Joshua2046c/replicator-project-6/product/README.md

# 四件式中式提灯

根据用户上传的提灯外形、补充角度和圆饼灯尺寸图制作：提手、底座、内胆、灯罩四个功能部件；提手拆为顶梁和两根竖杆，共六个独立打印实体。提手按最新参考改为双立杆支撑、两端上翘横梁的造型；灯罩改为上下圆弧过渡的直筒及纵向波纹，取消底部走线槽；灯罩与内胆磁吸位改为两处。底座与内胆下侧磁吸位也改为两处，底座外形与提手轮廓保持不变。仅参考新图的提手，不把提灯改成盒体。提手默认暖木色PETG，不代表采用实木工艺；其余保留青绿、米黄配色。按用户要求简化结构，去掉外伸耳座、锥形托台及叠层法兰。参考照片没有展示全部内部细节，浅托盘与镂空直筒的内部实现属于设计默认，并非照片实测结构。

## 明确要求
- 最新绿色标注区域整圈从顶到底统一壁厚，以原最薄处约1.2 mm为基准，包含纵向波纹、上肩圆弧和波纹下缘；内壁跟随外壁凹凸。
- 不再保留标注范围内原1.5 mm厚肩或上下厚壁渐变带；未标注磁铁安装环保留，孔位及装配尺寸不变。
- 灯罩纵向凹槽连续延伸经过收口肩部至口沿，不保留光滑肩带。
- 灯罩上口略微内收，内胆最高点不得高于灯罩口沿。
- 内胆容纳直径 60 mm、厚 8 mm 的成品圆饼灯组。
- 灯罩—内胆、内胆—底座以直径 7 mm、厚 2 mm 的磁铁配对连接。
- 顶梁与两根竖杆分件，竖杆顶端方桩插入顶梁底面配对盲孔。
- 提手与底座采用方桩固定；两侧方孔远离外边缘，插桩截面略缩小。
- 灯罩底部不再开走线凹口；保留内胆原有走线缺口，从灯罩下方外露灯杯引出导线。

## 本版默认尺寸和结构
- 装配目标外廓约 180 × 114 × 218 mm；灯罩主体高76 mm。横梁底面高192 mm，允许灯罩上提84 mm；越过内胆顶圈需要超过74 mm，保留约10 mm余量，避免横梁挡住拆卸。
- 底座是直径 114 mm、高 12 mm 的浅圆托盘，底厚 4 mm，盘内径 90 mm。方孔直接位于盘沿，不增加外伸耳座；提手下端向内折脚与盘沿连接。
- 灯罩采用半透明 PETG，40道纵向波纹，直筒中段不收腰；外径波谷106 mm、波峰109.6 mm，主体高76 mm。下端外径94 mm、圆弧过渡半径7.8 mm；上口波谷单边内收4 mm，波谷外径86 mm、波峰87.2 mm，以11.8 mm圆弧为上肩基准。凹槽从筒身连续到口沿，径向波深由1.8 mm渐变至0.6 mm。标注整圈内壁按外表面法线偏置约1.2 mm重建，取消原6 mm厚壁渐变带；上肩与直壁使用一致参数的波纹截面，避免放样扭曲。抽查直壁及上肩最小曲面距离1.1971 mm，波纹下缘至内侧底圆弧1.1988 mm，顶口轴向厚度1.2 mm。数值为CAD样条近似，不是打印公差。未标注底部磁吸环外径94 mm、高4 mm，局部加厚；孔不直接开在薄壁上。圆形顶孔82.4 mm和底孔69.2 mm不变，顶口平面径向宽度仍1.8–2.4 mm；该宽度不代表肩部法向壁厚。
- 内胆为一体直筒结构：下部直径 88 mm、高 28 mm 的圆柱灯杯，上部直径 68.4 mm 的镂空筒和顶圈，总高 102 mm。12 个竖向透光口直接开在筒壁上，没有独立立柱支架和锥形法兰。灯组槽直径 60.6 mm，底厚 6 mm；厚 8 mm 的灯从顶部直径 63 mm 开口取放。
- 灯罩从内胆上方直接套下，下口直径 69.2 mm 对内胆外径 68.4 mm，径向间隙 0.4 mm；在圆柱灯杯上端磁吸定位。顶部开口82.4 mm，内胆顶圈装配Z106、低于灯罩口沿Z108约2 mm，下部露出直筒灯杯。
- 灯罩—内胆改为两个对称定位点（0/180°），两侧各两枚、共四枚磁铁；内胆—底座也采用两个对称定位点（0/180°），两侧各两枚、共四枚，整灯合计8枚。两个点是每个接口的定位点数量，不是整灯磁铁总数。磁铁孔默认直径 7.2 mm、深 2.15 mm，给 Ø7×2 mm 磁铁留胶和打印误差空间。磁铁实际尺寸与孔的装配余量分开记录。
- 提手两立杆直径10 mm、中心距130 mm，底部保留内折脚以对接原有底座。横梁总宽180 mm、前后厚14 mm、中段高12 mm、两端相对中段上翘14 mm，端面斜切；顶梁与左右立杆分三件打印。顶部方桩6.4 × 6.4 mm、方孔6.8 × 6.8 mm，中心X±65 mm，单边间隙0.2 mm；桩顶Z200、孔顶Z200.2，端部留0.2 mm。名义桩长8 mm、孔深8.2 mm从横梁中段底面Z192计，杆肩贴合原下弧面，实际外露桩长约7.30–7.83 mm；顶梁前后孔壁各3.6 mm，孔顶剩余厚度至少3.8 mm。上下方桩均需胶接防拔。根部保留止挡肩，方桩缩为7.4 × 7.4 mm，插入8 mm；方孔为7.8 × 7.8 mm、深8.2 mm。孔与桩中心均为X±50.4 mm（中心距100.8 mm），相对原位置各内移0.6 mm，单边间隙0.2 mm；孔到内盘壁最小留肉1.5 mm，到外缘圆角起点的顶面最窄留肉约1.56 mm。方桩仍需胶接防拔。
- 仅保留内胆后部8 mm宽走线缺口，灯杯开口贯通到上沿。导线在底座盘沿Z12上方、灯罩底面Z32下方的外露灯杯处侧向引出，不夹在磁吸面之间。
- 除灯罩外采用不透明 PETG，颜色仅为设计默认。打印公差尚未用实物试装校准。

## 电气边界及证据
这是用户已有成品灯组的机械配套，依据上传尺寸图，不引入控制板、替换灯组或自定义 PCB。用户没有给出灯组品牌、电压、功率及接头尺寸；保留原装线和原配电源，不改线、不推断电源规格。灯组和磁铁不以猜测的供应商模型加入四件式 CAD。走线空间针对导线本体，内胆开放缺口使较大的接头无需穿孔；2 米线长来自图中标注，不要求收纳整条线。

## 验收及交付
交付含六个独立实体的 STEP 装配模型，检查六件之间无非预期干涉、两组磁铁孔共轴、方桩和方孔配合、圆饼灯腔及走线缺口尺寸。外观需要对照参考图检查。此版是可打印设计首版，打印层高、支撑、材料透光效果、胶接与磁力需样件验证。

## 独立水波纹替换灯罩
保留原提灯及纵向波纹灯罩，额外制作一个可互换的水波纹灯罩并放在旁边。参考上传金属壶的自然流动海浪纹，波带不能层层等宽或平行复制；每条波带沿圆周渐宽、渐窄，每道棱线独立起伏，相邻棱线自然靠拢、展开，同时保留清晰棱脊和立体明暗。标注的内凹过渡改为顺滑弧面；凸起棱脊的折角和邻近原斜面保持不变。默认半透明PETG。

默认沿用高76 mm、最大外径约109.6 mm、顶孔82.4 mm、底孔69.2 mm及两处Ø7.2×2.15 mm磁铁孔（半径39.2 mm、0/180°）。内壁随外形按约1.2 mm面法向偏置，棱角处以内侧斜面交线连接；底部4 mm磁吸环加厚。默认5道不平行的流动棱线，各层使用不同高度、弯曲相位、起伏幅度和局部宽窄分配。波谷控制点的名义深度3.2 mm，加入弧面后实际凹谷较控制点更柔和；13 mm仅作为总体轴向跨度控制，不是固定层距。默认凹谷过渡覆盖原谷点到两侧棱线各65%的范围，采用相切二次曲线，不是固定半径圆角；靠近凸棱的35%原斜面保留。主波4 mm、次波1.2 mm按各层系数和相位分别叠加；上下收口用圆弧轮廓的分段斜面自然收束。展示位置在原提灯右侧180 mm，底面同为Z32 mm；实际装配时与原灯罩择一使用，不能叠装。备用灯罩另需两枚Ø7×2 mm磁铁，连同原灯共10枚。
