Joshua2046c/replicator-project-6/design/lantern/README.md

# 中式四件提灯

四个功能部件、六个独立打印实体：顶梁、左竖杆、右竖杆组成提手，另外为浅圆托盘、镂空直筒内胆、圆弧直筒波纹薄壁灯罩。按补充角度简化，删除外伸耳座、锥台、多层法兰及三柱支架；只保留必要的磁吸环面。灯罩取消双鼓收腰，改为上下圆弧过渡的直筒，外围40道纵向波纹；取消灯罩底部走线槽。上口略微内收，40道凹槽连续经过收口肩部至口沿，内胆顶圈低于灯罩口沿，不向上突出。镂空直筒是本版默认内部实现，不声称由照片确认了隐藏结构。

用户指定灯组 Ø60×8 mm，磁铁 Ø7×2 mm。灯组品牌、电压及功率未知，保留原配线束和电源，不新增电路；空 connections 表示无新接线，不代表电气验证。

## 接口
- 最新绿色标注整圈从上肩到纵向波纹下缘统一约1.2 mm法向壁厚，以原最薄处为基准；内外40道凹凸对应。不再保留原厚肩或6 mm渐变厚壁带。依据 shade_uniform_wall_reference。
- 保留顶孔82.4 mm、底孔69.2 mm和未标注磁铁安装环（外径94 mm、高4 mm、两孔Ø7.2×2.15 mm）。外表面用一致参数重建波纹放样，保持外廓、波纹数量和收口尺寸。
- 灯腔 Ø60.6 mm，座面装配 Z10，8 mm 灯顶面 Z18，杯口 Z32；顶部取放孔 Ø63 mm。
- 底座—内胆 Z4，两处0/180°；内胆—灯罩 Z32，两处0/180°。两组磁铁孔分布半径均39.2 mm，孔 Ø7.2×2.15 mm。灯罩侧两枚、内胆上侧两枚、内胆下侧两枚、底座两枚，共8枚 Ø7×2 mm磁铁。
- 提手方桩与方孔中心 X±50.4 mm，中心距100.8 mm，各比原位置向内移0.6 mm；方桩7.4 mm配7.8 mm方孔，单边间隙0.2 mm，插深8 mm，孔深8.2 mm。孔至内盘壁留肉1.5 mm；孔外角至底座外圆角起点的顶面留肉约1.56 mm（原约0.8 mm）。方孔直接开在盘沿，胶接固定。
- 内胆直筒外径68.4 mm，灯罩下口69.2 mm，径向装配间隙0.4 mm；灯罩可从上方套入或提起，不会被顶圈扣住。
- 只保留内胆负Y方向8 mm宽走线缺口，从灯座面开到杯口，与一处筒壁透光口对齐。灯罩底部完整无走线开槽；导线从外露灯杯侧面引出。
- 最新提手照片登记为 handle_reference，明确采用双立杆与翘头横梁；当前保留该提手，灯罩及内胆上侧磁铁孔按最新标注更新。根据 beam_joint_reference 将提手分为顶梁、左竖杆、右竖杆三个实体，以顶部方桩连接，底部插桩、立杆间距和翘头横梁轮廓不变。方孔与插桩修改标注为 square_joint_reference。底座与内胆两点磁吸标注为 base_magnets_reference，凹槽延伸收口标注为 rim_fluting_reference，收口与内胆高度标注为 rim_revision_reference，灯罩修改标注为 shade_revision_reference，补充提灯照片为 lantern_reference_side；外廓、透光口数量、隐藏结构和暖木色PETG属于设计默认。

- 顶部方桩6.4 mm、配对盲孔6.8 mm，中心X±65 mm，单边间隙0.2 mm；桩顶Z200、孔顶Z200.2，端部余量0.2 mm。名义桩长8 mm和孔深8.2 mm从Z192计；杆肩贴合顶梁原下弧面，实际外露桩长约7.30–7.83 mm。孔前后壁各3.6 mm，孔顶厚度至少3.8 mm。直方桩采用胶接防拔，不是卡扣。

## Making and assembly
默认0.4 mm喷嘴、0.16–0.20 mm层高；提手分顶梁与两根竖杆分别用PETG打印，默认暖木色而非实木。顶梁宽侧面平放，竖杆沿长度方向平放，使上下方桩轴线位于打印平面内，避免沿承力方向叠层。圆杆下侧、折脚和上下方桩需切片检查局部支撑与床面接触，勿让方桩配合面被支撑损坏；顶梁盲孔的横向桥接也需检查。底座底面向下。内胆灯杯底面向下，筒壁竖向肋低速打印；透光窗口顶部约9 mm桥接需检查切片。灯罩竖直、下环放平台，薄壁用半透明PETG；上口内收后的肩部检查局部支撑与悬垂，不能用花瓶单壁模式，因为底环含磁铁盲孔。薄壁筒身需在切片预览中检查连续壁线，不能把1.2 mm简单等同于固定三圈实际线宽。模型未实际打印。

先干试方桩和磁铁孔，需要时通过参数调整补偿。确认每对磁铁相吸后标记，少量胶粘并防止固化前移位。先粘底座两枚与内胆下侧两枚，再粘内胆上侧两枚及灯罩两枚磁铁；上下接口均为两对，分别核对配对极性。先干试顶梁与两根竖杆，保持折脚向内、两组方桩中心对齐；将顶部两方桩胶接到顶梁盲孔，再将底部两方桩胶接到盘沿，所有承力胶接完全固化后才可提起；直方桩的打印间隙不是防拔锁扣。

灯从内胆顶部放到底面，导线从负Y方向侧向放入缺口，再放上内胆和灯罩。底座盘沿会遮住低处一小段缺口，导线须向上绕至盘沿上方，在Z12至Z32的外露灯杯区域侧向引出，不夹在磁吸面之间。磁铁若各下沉0.15 mm，两侧总气隙0.3 mm，实际吸力须样件验证。维修时先提灯罩再取内胆，禁止以灯罩代替提手悬提。灯组发热、透光、磁力承重与胶接寿命均未实测。

## 尺寸与验证边界
目标外廓180×114×218 mm。底座外径114 mm、高12 mm、底厚4 mm、内径90 mm；内胆灯杯外径88 mm，在托盘内径向间隙1 mm。提手立杆直径10 mm、中心距130 mm；横梁宽180 mm、深14 mm、中段高12 mm、端部上翘14 mm。灯罩主体高76 mm，直筒波谷直径106 mm、波峰109.6 mm，下端外径94 mm、外部圆弧半径7.8 mm；上口波谷单边内收4 mm，波谷外径86 mm、波峰87.2 mm；以11.8 mm圆弧为上肩放样基准，纵向凹槽连续覆盖肩部并到达口沿，径向波深由筒身1.8 mm平滑渐变至口沿0.6 mm，口沿径向厚度1.8–2.4 mm。圆形顶孔仍为82.4 mm。40道纵向波纹，标注范围内直壁与上肩统一约1.2 mm法向壁厚。代表性曲面测量：直壁和上肩各1.1971 mm，下缘至底内圆弧1.1988 mm，顶口轴向1.2 mm；样条近似已按1.2±0.01 mm检查。未标注磁铁安装环局部加厚，不把环上径向安装面宽度当作透光壁厚。内胆总高102 mm，顶圈装配Z106 mm，比灯罩口沿Z108 mm低2 mm。横梁中段底面装配Z192 mm；灯罩顶面Z108 mm，可上提84 mm，脱离内胆需上提74 mm，保留约10 mm拆装余量。

本次几何和外观检查以产品验证记录所指向的确切模型为准；打印公差、材料透光和实际承重仍需实物验证。
