Joshua2046c/replicator-project-6/product/gallery/codex-image-2026-10-1-19-55-11.jpg

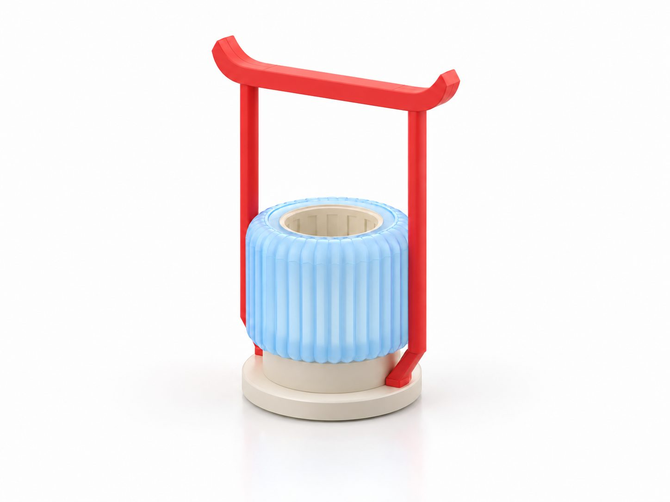
product/gallery/codex-image-2026-10-1-19-55-11.jpg
