Joshua2046c/replicator-project-6/product/bom.csv

id | name | quantity | source | notes
handle | 双盲孔翘头顶梁 PETG 暖木色 | 1 | default | 非实木 顶部方孔6.8mm 中心距130mm
handle_left_rod | 左竖杆 PETG 暖木色 | 1 | default | 上桩6.4mm 下桩7.4mm 上下均胶接
handle_right_rod | 右竖杆 PETG 暖木色 | 1 | default | 上桩6.4mm 下桩7.4mm 上下均胶接
base | 带双方孔浅圆托盘 PETG 青色 | 1 | default | 打印件 方孔7.8mm 中心距100.8mm
liner | 低于灯罩口沿的圆饼灯镂空直筒内胆 PETG 米黄色 | 1 | default | 打印件
shade | 整圈内外对应波纹等厚灯罩 约1.2mm 半透明PETG 绿色 | 1 | default | 标注上肩及筒壁同厚 未标注磁吸环保留 两处磁铁孔
magnet_7x2 | 轴向充磁圆片磁铁 Ø7×2 mm | 10 | user_dimensions | 原灯8枚 水波纹备用灯罩2枚
light_60x8 | 用户图示 Ø60×8 mm 圆饼灯组 含原装线及匹配电源 | 1 | user | 保留原装电气系统
adhesive | 适用于 PETG 与镀镍磁铁的双组分环氧胶 | 1 | default | 装配耗材
water_shade | 自然流动海浪纹替换灯罩 凹谷弧面及锐棱 约1.2mm 半透明PETG | 1 | default | 凹谷相切弧面 凸棱折角不变 宽窄自然变化 两处磁铁孔
