Joshua2046c/replicator-project-6/manufacturing/lantern/releases/export-cfa25840fb57574f5817fed4d6e9c91b/model.step

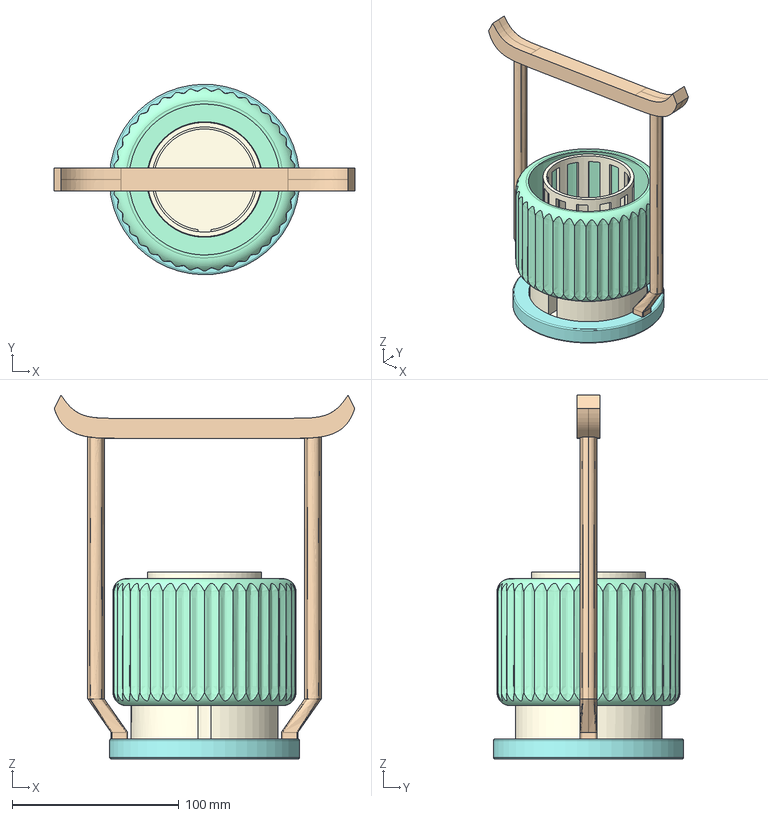
[picture p2: CAD file, 2026-09-25]
manufacturing/lantern/releases/export-cfa25840fb57574f5817fed4d6e9c91b/model.step
180.0 x 113.9 x 218.0 mm
base
ﾃδεつｧﾃδづつｿﾃδεつ･ﾃδづつ､ﾃδづつｴﾃδεつｦﾃδづつｨﾃδづつｪﾃδεつ ｦﾃδづつ｢ﾃδεつｦﾃδεつｦ
liner
shade
