Joshua2046c/replicator-project-6/(commit log)

2026-09-24 chore: initialize project structure with manifest and references
    Add project manifest, reference index, and gitignore for a hardware project named "提灯". The gitignore excludes build artifacts, working directories, and uploaded reference images while preserving metadata files.
2026-09-24 feat(cad): build four-part magnetic Chinese lantern
    [bom.csv, model.step]
2026-09-24 fix(cad): simplify lantern tray and cylindrical liner
    [bom.csv, model.step]
2026-09-25 feat(cad): refine fluted lantern shade and paired magnet mounts
    [bom.csv, model.step]
2026-09-25 fix(cad): inset shade rim and recess lantern liner
    [bom.csv, model.step]
2026-09-25 fix(cad): extend lantern fluting over inset rim
    [bom.csv, model.step]
2026-09-25 fix(cad): use two paired magnets at lantern base
    [bom.csv, model.step]
2026-09-25 fix(cad): inset handle sockets and slim square tenons
    [bom.csv, model.step]
2026-09-25 feat(cad): join beam and rods with square tenons
    [bom.csv, model.step]
2026-09-26 fix(cad): thicken shade shoulder to 1.5 mm
    [bom.csv, model.step]
2026-10-12 feat(cad): add inner shade waves with 1.2 mm body wall
    [bom.csv, model.step]
2026-10-16 chore: publish to the community
    [bom.csv, model.step]
